kitnic-forks/e100a/README.md

E100A All-Discrete Power Supply Kit
==================================

Work in progress. This will be a semi-educational kit for a bench power
supply made from all discrete components.

3D render
