kitnic-forks/e100a/doc/titlepage/titlepage.tex

\begin{titlepage}

\makeatletter

\centering
\begin{minipage}[c][1in][c]{6in}
\vspace{-1.5in}

\end{minipage}

\vspace{-1in}
\vspace*{\fill}
\begin{center}
{\LARGE\@title}

\vspace{10mm}

\url{http://c4757p.com/projects/ps1}

\end{center}
\vspace*{\fill}

\vspace{-1in}
\begin{minipage}[c][1in][c]{\textwidth}
\begin{center}
 \\
\textcopyright ~\the\year ~\@author.
\end{center}
\end{minipage}

\makeatother

\end{titlepage}
