kitnic-forks/e100a/images/kicad-3d-not-stuffed.png

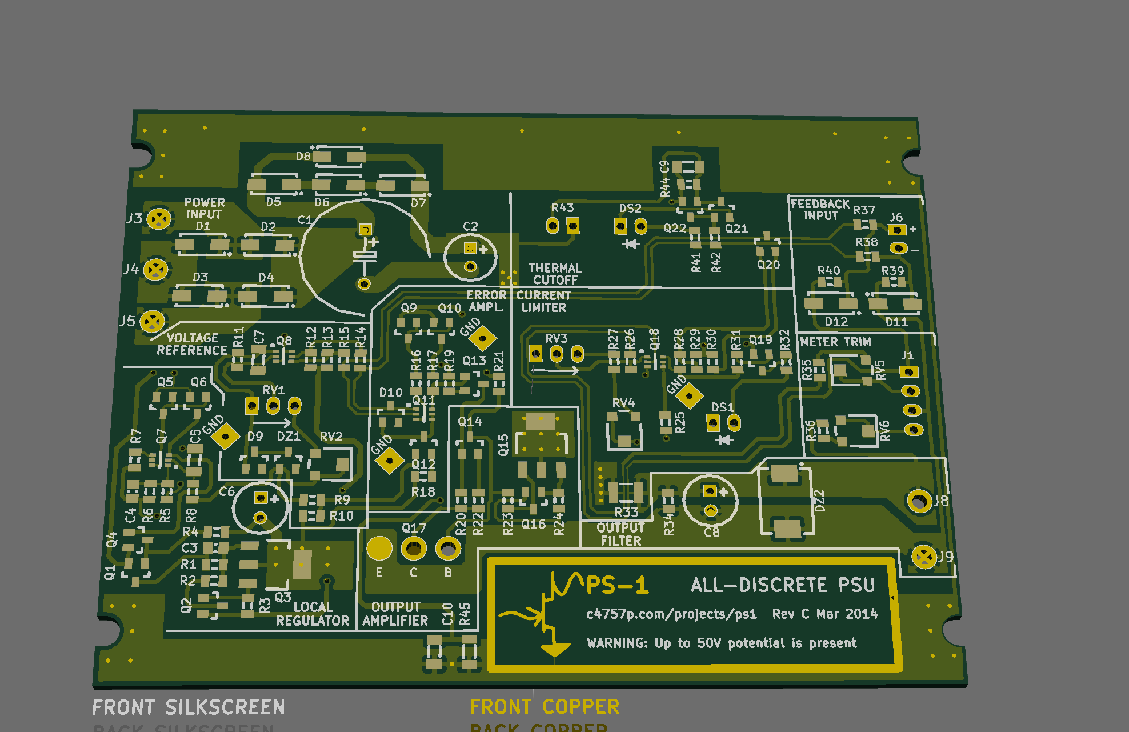
images/kicad-3d-not-stuffed.png
