kitnic-forks/e100a/BOM.ods

Type | Item | Description | Source | Manufacturer | Source PN | Qty | USD Cost qty. | Notes on sourcing
C | C1 | CAP Alum 1000uF 63V [Radial 16mm]
C | C2 | CAP Alum 47uF 63V [Radial 6.3mm]
C | C6 | CAP Alum 47uF 63V [Radial 6.3mm]
C | C8 | CAP Alum 47uF 63V [Radial 6.3mm]
C | C3 | CAP Ceramic 100pF 50V [0805]
C | C4 | CAP Ceramic 1nF 16V [0805]
C | C10 | CAP Ceramic 1nF 1kV [1206]
C | C5 | CAP Ceramic 4.7uF 16V [1206]
C | C7 | CAP Ceramic 4.7uF 16V [1206]
C | C9 | CAP Ceramic 4.7uF 16V [1206]
C | C(FP) | CAP Film 100nF 200V [Radial, long leads]
D | D1 | DIODE 1A 200V [SMA]
D | D11 | DIODE 1A 200V [SMA]
D | D12 | DIODE 1A 200V [SMA]
D | D2 | DIODE 1A 200V [SMA]
D | D3 | DIODE 1A 200V [SMA]
D | D4 | DIODE 1A 200V [SMA]
D | D5 | DIODE 1A 200V [SMA]
D | D6 | DIODE 1A 200V [SMA]
D | D7 | DIODE 1A 200V [SMA]
D | D8 | DIODE 1A 200V [SMA]
D | D10 | DIODE Signal [SOT-23]
D | D9 | DIODE Signal [SOT-23]
D | DZ2 | DIODE TVS 30V WPIV 33A IRSM [SMC-J]
D | DZ1 | DIODE Zener 6.2V 2% [SOT-23]
DS | DS1 | INDICATOR LED Red [Panel 6.35mm] | DigiKey | Bivar | 492-1659-ND |  | $0.404
DS | DS2 | INDICATOR LED Red [Panel 6.35mm] | DigiKey | Bivar | 492-1659-ND |  | $0.404
R | R33 | RES {1 / 0.47 / 1} 5% [1210]
R | R37 | RES {120k 75k 75k} 0.5% [0805]
R | R38 | RES {120k 75k 75k} 0.5% [0805]
R | R35 | RES {180 68 180} 5% [0805]
R | R36 | RES {27k 15k 27k} 5% [0805]
R | R11 | RES 100k 5% [0805]
R | R26 | RES 100k 5% [0805]
R | R42 | RES 100k 5% [0805]
R | R25 | RES 10k 5% [0805]
R | R31 | RES 10k 5% [0805]
R | R32 | RES 10k 5% [0805]
R | R41 | RES 10k 5% [0805]
R | R7 | RES 10k 5% [0805]
R | R8 | RES 10k 5% [0805]
R | R6 | RES 18k 5% [0805]
R | R16 | RES 1k 5% [0805]
R | R17 | RES 1k 5% [0805]
R | R18 | RES 1k 5% [0805]
R | R19 | RES 1k 5% [0805]
R | R20 | RES 1k 5% [0805]
R | R22 | RES 1k 5% [0805]
R | R28 | RES 1k 5% [0805]
R | R29 | RES 1k 5% [0805]
R | R45 | RES 1M 5% [1206]
R | R14 | RES 22k 0.5% [0805]
R | R15 | RES 22k 0.5% [0805]
R | R1 | RES 22k 5% [0805]
R | R12 | RES 22k 5% [0805]
R | R13 | RES 22k 5% [0805]
R | R21 | RES 22k 5% [0805]
R | R23 | RES 22k 5% [0805]
R | R27 | RES 22k 5% [0805]
R | R34 | RES 22k 5% [0805]
R | R4 | RES 22k 5% [0805]
R | R5 | RES 22k 5% [0805]
R | R39 | RES 270 5% [0805]
R | R40 | RES 270 5% [0805]
R | R44 | RES 270 5% [0805]
R | R24 | RES 33 5% [0805]
R | R3 | RES 33 5% [0805]
R | R30 | RES 33 5% [0805]
R | R10 | RES 470 5% [0805]
R | R9 | RES 470 5% [0805]
R | R43 | RES Therm 100k 5% [Radial]
Q | Q15 | TRANS NPN [SOT-223]
Q | Q3 | TRANS NPN [SOT-223]
Q | Q12 | TRANS NPN [SOT-23]
Q | Q14 | TRANS NPN [SOT-23]
Q | Q16 | TRANS NPN [SOT-23]
Q | Q2 | TRANS NPN [SOT-23]
Q | Q22 | TRANS NPN [SOT-23]
Q | Q11 | TRANS NPN Matched [SOT-363]
Q | Q18 | TRANS NPN Matched [SOT-363]
Q | Q7 | TRANS NPN Matched [SOT-363]
Q | Q8 | TRANS NPN Matched [SOT-363]
Q | Q10 | TRANS PNP [SOT-23]
Q | Q19 | TRANS PNP [SOT-23]
Q | Q20 | TRANS PNP [SOT-23]
Q | Q21 | TRANS PNP [SOT-23]
Q | Q5 | TRANS PNP [SOT-23]
Q | Q6 | TRANS PNP [SOT-23]
Q | Q9 | TRANS PNP [SOT-23]
Q | Q1 | TRANS PNP 60V [SOT-23]
Q | Q13 | TRANS PNP 60V [SOT-23]
Q | Q4 | TRANS PNP 60V [SOT-23]
Q | Q17 | TRANS PNP Darlington hFE>=1000 60V w/Diode [TO-220]
J | J(BP) | CONNECTOR IEC-C14 QuickConnect 6.35mm | DigiKey | Qualtek | Q212-ND |  | $0.689
MP | MP-J(BP) | CONNECTOR QuickConnect 6.35mm crimp | DigiKey | Molex | WM5929-ND | 5 | $0.318
SW | SW(FP)2 | SWITCH 250VAC QuickConnect 6.35mm [Panel] | DigiKey | Arcolectric | 1091-1034-ND |  | $1.660
DS | DS3 | INDICATOR LED Red [Panel 6.35mm] | DigiKey | Bivar | 492-1659-ND |  | $0.404
R | R2 | RES 10k 5% [0805]
SW | SW(FP)1 | SWITCH Momentary 3A [Panel] | DigiKey | E-Switch | EG2031-ND |  | $1.970
RV | RV1 | POT 10k Linear [Panel, Solder Lug]
RV | RV2 | POT TRIM 10k [SMD]
RV | RV3 | POT 1k Linear [Panel, Solder Lug]
RV | RV4 | POT TRIM 10k [SMD]
RV | RV5 | POT TRIM 500 [SMD]
RV | RV6 | POT TRIM {20k 10k 10k} [SMD]
M | M(FP) | METER 1mA, 240 ohm, custom scale [Panel] | AliExpress |  | 1180028889 |  | $3.210
L | L(FP) | FERRITE Ring 161 ohm @ 1 turn [10mm inner] | DigiKey | Wurth | 732-1522-ND |  | $0.739
MP | MP-F(FP) | SOCKET Fuse 6.3mm [Inline] | DigiKey | Littelfuse | F3108-ND |  | $0.740
F | F(FP) | FUSE 1A 125V slow [6.3mm] | DigiKey | Bel Fuse | 507-1526-ND |  | $0.334
