kitnic-forks/e100a/simulation/sim-full.asc

C1: polcap; 1000µ; V=63
C2: polcap; 47µ; V=63 Rser=2.6
C3: cap; 330p
C4: cap; 1n
C5: cap; 4µ7
C6: polcap; 47µ; V=63 Rser=2.6
C7: cap; 4µ7
C8: polcap; 47µ; V=63 Rser=2.6
C9: cap; 1n
C10: cap; 1n
D1: diode; S1D
D2: diode; S1D
D3: diode; S1D
D4: diode; S1D
D5: diode; S1D
D6: diode; S1D
D7: diode; S1D
D8: diode; S1D
D9: diode; 1N4148
D10: diode; 1N4148
D11: diode; 1N4148
DZ1: diode; BZX84C6V2
Q1: pnp; 3906
Q2: npn; 3904
Q3: npn; 2N2222
Q4: pnp; 3906
Q5: pnp; 3906
Q6: pnp; 3906
Q7: pnp; 3906
Q7A: npn; 3904
Q7B: npn; 3904
Q8: npn; 3904
Q8A: npn; 3904
Q8B: npn; 3904
Q9: pnp; 3906
Q10: pnp; 3906
Q11: npn; 3904
Q11A: npn; 3904
Q11B: npn; 3904
Q12: npn; 3904
Q13: npn; 3904
Q14: npn; 3904
Q15: npn; 2N2222
Q16: npn; 3904
Q17: npn; 3904
Q18: pnp; 3906
R1: res; 22k
R2: res; 33
R3: res; 33
R4: res; 22k
R5: res; 30k
R6: res; 22k
R7: res; 10k
R8: res; 10k
R9: res; 470
R10: res; 470
R11: res; 100k
R12: res; 22k
R13: res; 22k
R14: res; 22k
R15: res; 22k
R16: res; 1k
R17: res; 1k
R18: res; 22k
R19: res; 1k
R20: res; 1k
R21: res; 22k
R22: res; 1k
R23: res; 22k
R24: res; 33
R25: res; 33
R26: res; 1k
R27: res; {IPOT}
R28: res; {1k-IPOT}
R29: res; {22k+ITRIM}
R30: res; 100k
R31: res; 10k
R32: res; 2k
R33: res; 1
R34: res; 22k
R35: res; 2k
R36: res; 1k
R37: res; 120k
R38: res; 120k
R39: res; 10k
R40: res; R=12/(0.1*time+1u)
R41: res; 1k
RV1A: res; {VPOT}
RV1B: res; {10k-VPOT}
RV2: res; {VTRIM}
U1: pnp-subckt; TIP105
V1: voltage; SINE(0 40 60)
V2: voltage; 0
V3: voltage; 0
V4: voltage; 0; AC 1
V5: voltage; 2; Rser=.1
V6: voltage; 38; Rser=.1
V7: voltage; 12; Rser=.1
Named nets: V-UNREG, 0, +2, -12, SENSE+, SENSE-, nfb, nfbin
.model S1D D
.lib diode.lib
.tran 10 startup
.model 3906 ako:2N3906
.model 3904 ako:2N3904
.param VTRIM 5k
.param VPOT 5k
.lib TIP105.lib
.param ITRIM 5k
.param IPOT 500
;ac dec 100 10 100Meg
