kitnic-forks/e100a/Proj-Main/psu.kicad_pcb

## KiCad design Proj-Main/psu.kicad_pcb (2014-05-16)

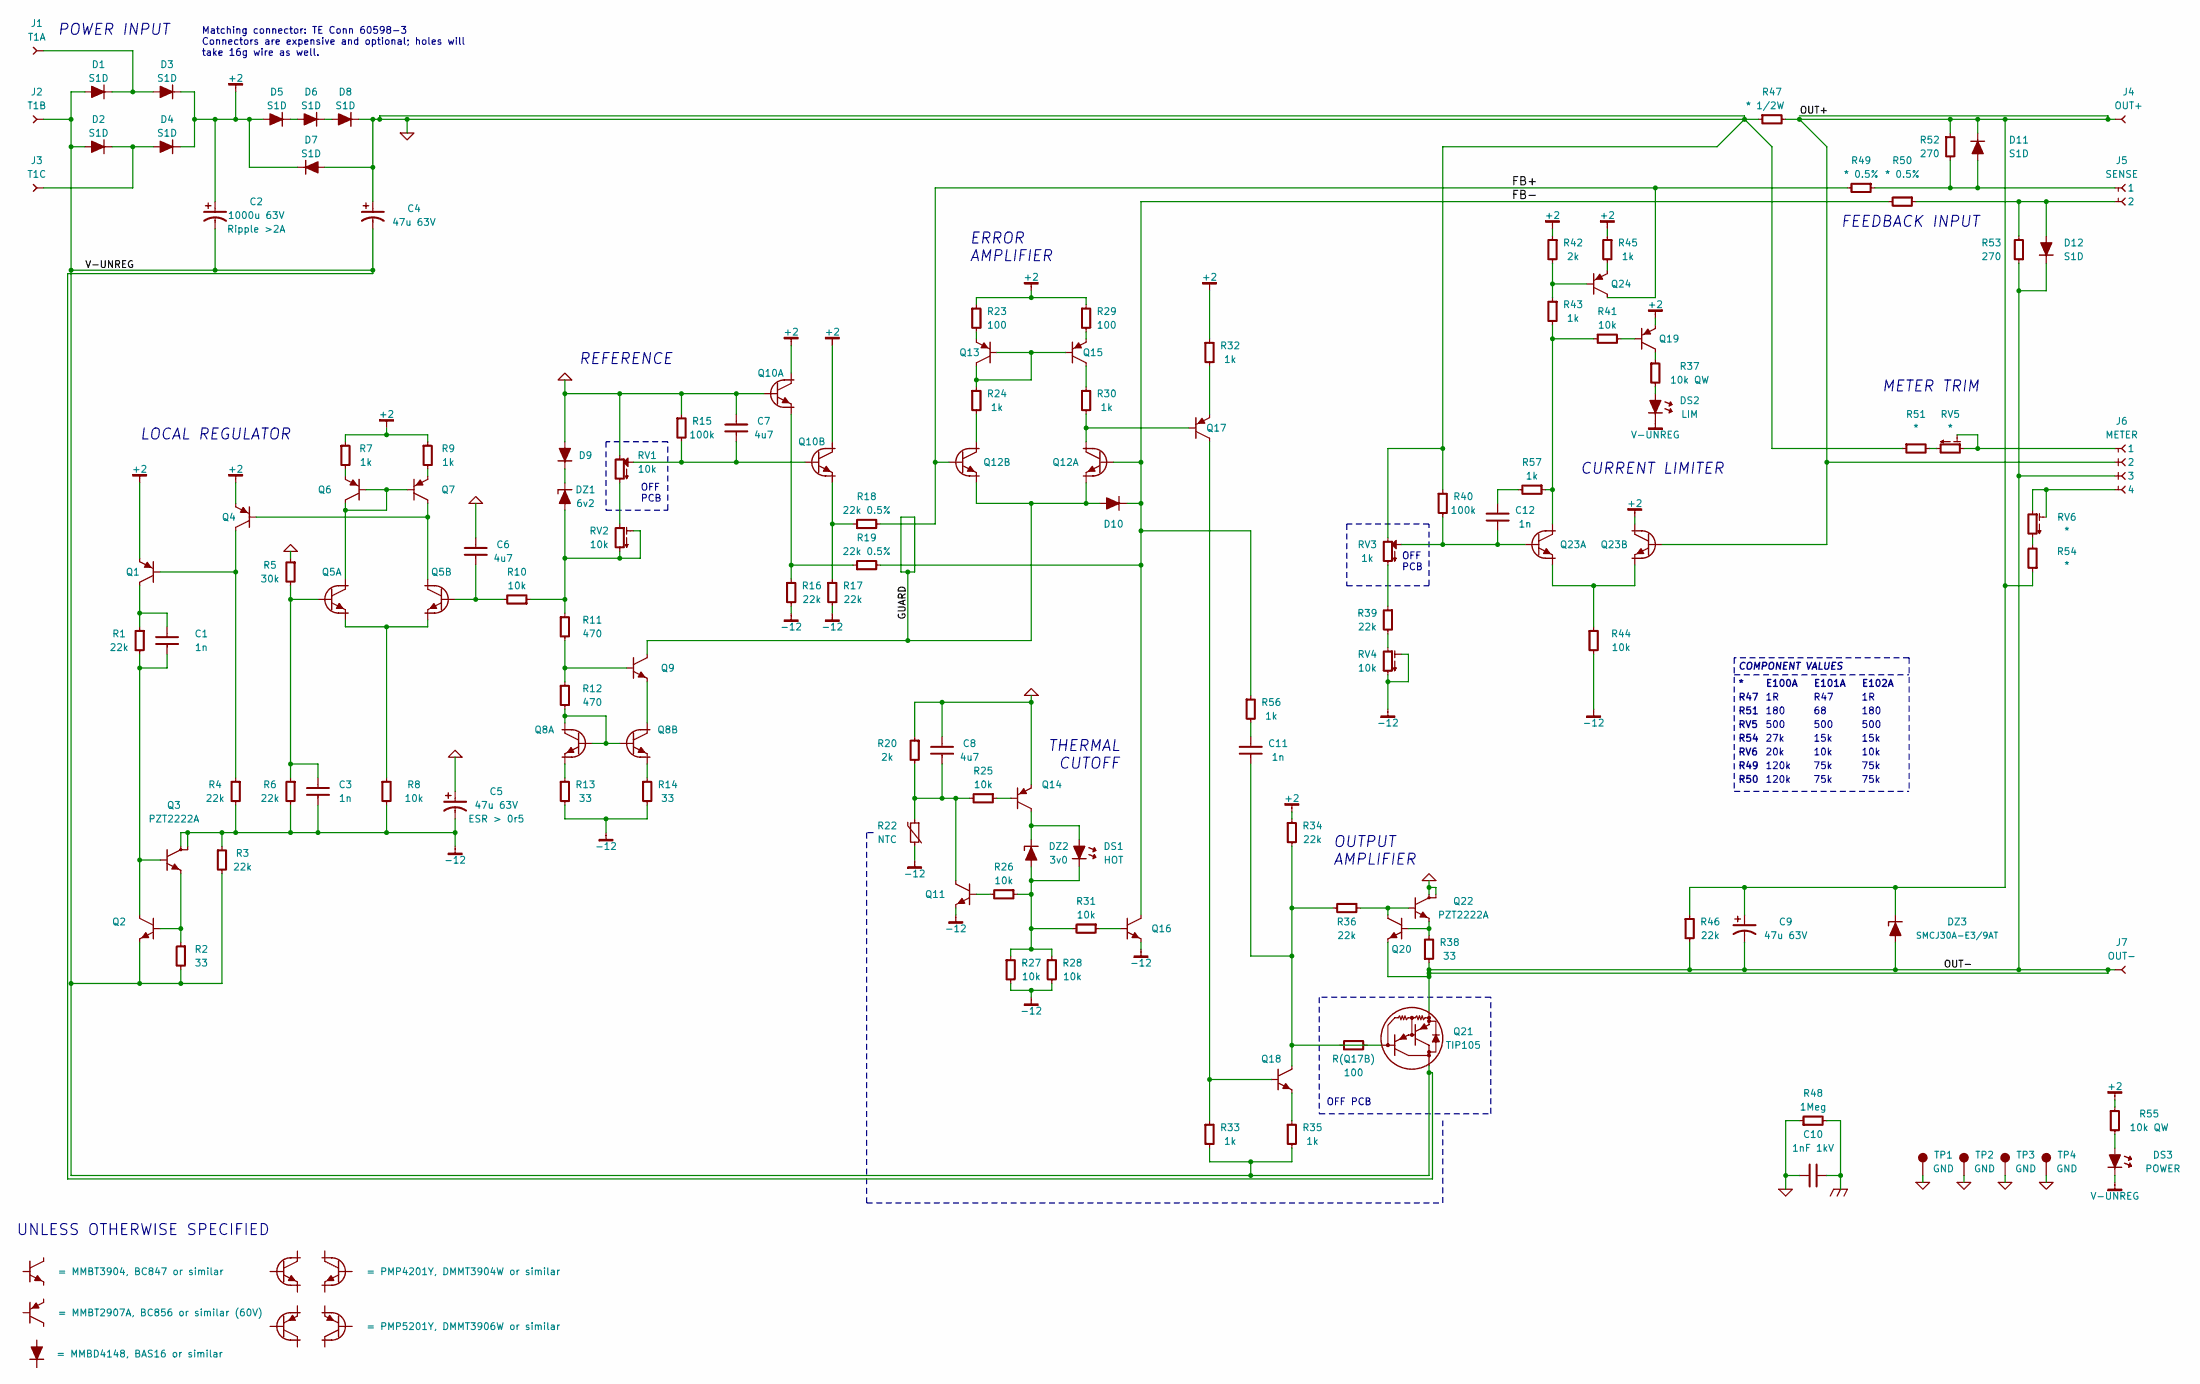
[picture p2: schematic psu.sch, E100A ALL-DISCRETE POWER SUPPLY]

Parts:
C1, C3, C11, C12: 1n
C2: 1000u 63V
C4, C5, C9: 47u 63V
C6, C7, C8: 4u7
C10: 1nF 1kV
D1, D2, D3, D4, D5, D6, D7, D8, D11, D12: S1D
D9, D10: MMBD4148
DS1: HOT; PartNo PM5RD
DS2: LIM; PartNo PM5RD
DS3: POWER; PartNo PM5RD
DZ1: 6v2; PartNo BZX84-B6V2
DZ2: 3v0
DZ3: SMCJ30A-E3/9AT
J1: T1A; PartNo 60824-1
J2: T1B; PartNo 60824-1
J3: T1C; PartNo 60824-1
J4: OUT+; PartNo 60824-1
J5: SENSE
J6: METER
J7: OUT-; PartNo 60824-1
Q1, Q4, Q13, Q15, Q17: BC856
Q2, Q9, Q11, Q16, Q18, Q20: MMBT3904
Q3, Q22: PZT2222A
Q5, Q8, Q10, Q12, Q23: PMP4201Y
Q6, Q7: MMBT3906
Q14, Q19, Q24: MMBT2907A
Q21: TIP105
R1, R3, R4, R6, R16, R17, R34, R36, R39, R46: 22k
R2, R13, R14, R38: 33
R5: 30k
R7, R9, R24, R30, R32, R33, R35, R43, R45, R56, R57: 1k
R8, R10, R25, R26, R27, R28, R31, R41, R44: 10k
R11, R12: 470
R15, R40: 100k
R18, R19: 22k 0.5%
R20, R42: 2k
R22: NTC; PartNo NTCLE100E3334JB0; MouserPN 594-2381-640-63104
R23, R29: 100
R37, R55: 10k QW
R47: * 1/2W
R48: 1Meg
R49, R50: * 0.5%
R51, R54: *
R52, R53: 270
RV1, RV2, RV4: 10k
RV3: 1k
RV5, RV6: *
TP1, TP2, TP3, TP4: GND

Connections:
+2: C2.1, D3.1, D4.1, D5.2, D7.1, Q1.2, Q4.2, Q10.3, Q10.6, Q19.2, Q23.3, R7.1, R9.1, R23.1, R29.1, R32.1, R34.1, R42.1, R45.1, R55.1
-12: C3.2, C5.2, Q3.2, Q3.4, Q11.2, Q16.2, R3.1, R4.2, R6.2, R8.2, R13.2, R14.2, R16.2, R17.2, R22.2, R27.2, R28.2, R44.2, RV4.2, RV4.3
/FB+: Q12.2, Q24.3, R18.2, R49.2
/FB-: D10.3, Q12.1, Q16.3, R19.2, R50.2, R56.1
/GUARD: D10.1, Q9.3, Q12.4, Q12.5
/OUT+: C9.1, D11.1, DZ3.K, J4.1, J6.2, Q23.2, R46.1, R47.2, R52.1, R54.1
/OUT-: C9.2, D12.1, DZ3.A, J6.3, J7.1, Q20.2, Q21.3, R38.1, R46.2, R53.1
CGND: C10.2, R48.2
GND: C4.1, C5.1, C6.1, C7.1, C8.1, C10.1, D7.2, D8.1, D9.1, Q10.1, Q14.2, Q22.2, Q22.4, R5.1, R15.1, R20.1, R40.1, R47.1, R48.1, R51.1, RV1.1, RV3.1, TP1.1, TP2.1, TP3.1, TP4.1
unnamed: C1.1, Q1.3, R1.1
unnamed: C1.2, Q2.3, Q3.1, R1.2
unnamed: C3.1, Q5.1, R5.2, R6.1
unnamed: C6.2, Q5.2, R10.2
unnamed: C7.2, Q10.2, R15.2, RV1.2
unnamed: C8.2, Q11.3, R20.2, R22.1, R25.2
unnamed: C11.1, R56.2
unnamed: C11.2, Q18.3, Q21.1, R34.2, R36.2
unnamed: C12.1, R57.2
unnamed: C12.2, Q23.1, R40.2, RV3.2
unnamed: D1.1, D3.2, J1.1
unnamed: D2.1, D4.2, J3.1
unnamed: D5.1, D6.2
unnamed: D6.1, D8.2
unnamed: D9.3, DZ1.3
unnamed: D11.2, J5.1, R49.1, R52.2
unnamed: D12.2, J5.2, R50.1, R53.2
unnamed: DS1.A, DZ2.3, Q14.3
unnamed: DS1.K, DZ2.1, R26.1, R27.1, R28.1, R31.2
unnamed: DS2.A, R37.2
unnamed: DS3.A, R55.2
unnamed: DZ1.1, R10.1, R11.1, RV2.2, RV2.3
unnamed: J6.1, RV5.1, RV5.2
unnamed: J6.4, RV6.1, RV6.2
unnamed: Q1.1, Q4.3, R4.1
unnamed: Q2.1, Q3.3, R2.1
unnamed: Q4.1, Q5.3, Q7.3
unnamed: Q5.4, Q5.5, R8.1
unnamed: Q5.6, Q6.1, Q6.3, Q7.1
unnamed: Q6.2, R7.2
unnamed: Q7.2, R9.2
unnamed: Q8.1, Q8.2, Q8.6, R12.2
unnamed: Q8.3, Q9.2
unnamed: Q8.4, R14.1
unnamed: Q8.5, R13.1
unnamed: Q9.1, R11.2, R12.1
unnamed: Q10.4, R17.1, R18.1
unnamed: Q10.5, R16.1, R19.1
unnamed: Q11.1, R26.2
unnamed: Q12.3, R24.2
unnamed: Q12.6, Q17.1, R30.2
unnamed: Q13.1, Q13.3, Q15.1, R24.1
unnamed: Q13.2, R23.2
unnamed: Q14.1, R25.1
unnamed: Q15.2, R29.2
unnamed: Q15.3, R30.1
unnamed: Q16.1, R31.1
unnamed: Q17.2, R32.2
unnamed: Q17.3, Q18.1, R33.1
unnamed: Q18.2, R35.1
unnamed: Q19.1, R41.2
unnamed: Q19.3, R37.1
unnamed: Q20.1, Q22.3, R38.2
unnamed: Q20.3, Q22.1, R36.1
unnamed: Q23.4, Q23.5, R44.1
unnamed: Q23.6, R41.1, R43.2, R57.1
unnamed: Q24.1, R42.2, R43.1
unnamed: Q24.2, R45.2
unnamed: R39.1, RV3.3
unnamed: R39.2, RV4.1
unnamed: R51.2, RV5.3
unnamed: R54.2, RV6.3
unnamed: RV1.3, RV2.1
V-UNREG: C2.2, C4.2, D1.2, D2.2, DS2.K, DS3.K, J2.1, Q2.2, Q21.2, R2.2, R3.2, R33.2, R35.2

Notes on the sheet:
ERROR AMPLIFIER
POWER INPUT
UNLESS OTHERWISE SPECIFIED
THERMAL CUTOFF
COMPONENT VALUES
E100A
E101A
E102A
R51
180
R54
27k
15k
RV5
500
RV6
20k
10k
R47
LOCAL REGULATOR
REFERENCE
OUTPUT AMPLIFIER
CURRENT LIMITER
FEEDBACK INPUT
METER TRIM
Matching connector: TE Conn 60598-3 Connectors are expensive and optional; holes will take 16g wire as well.
R49
120k
75k
R50
OFF PCB
OFF PCB

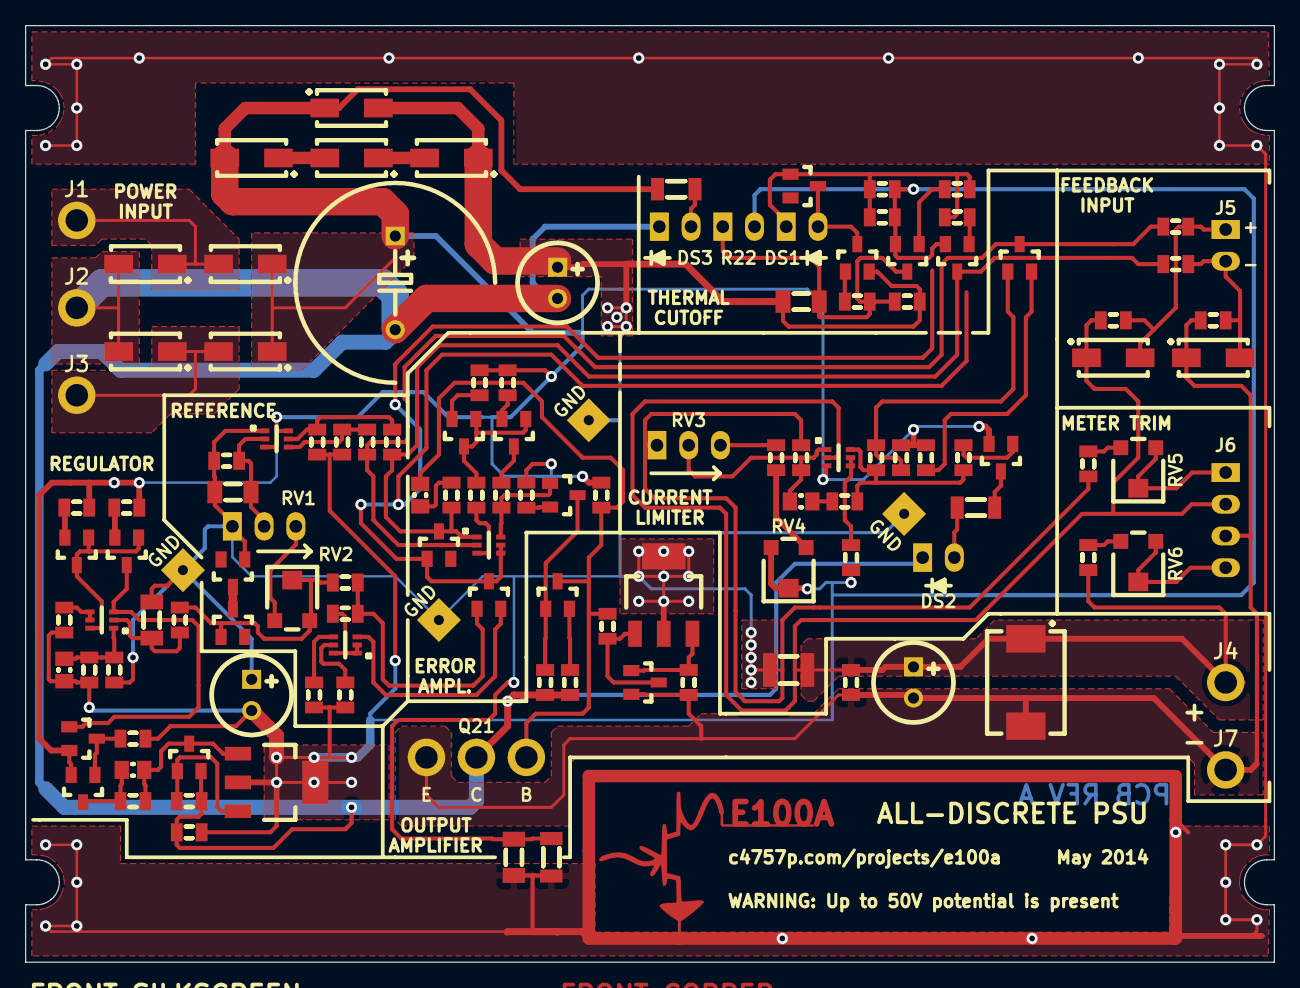
[picture p3: board psu.kicad_pcb from above]

Board: 2 copper layers, 100.0 x 75.0 mm, 127 parts (0 on the bottom side), 73 nets.
