kitnic-forks/e100a/(commit log)

2014-01-24 Finally put this in a git repo...
    [BOM.ods, log-fixed.csv, log.csv, logC.csv, noiseamp.kicad_pcb, noiseamp.sch, partsboard.ods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]
2014-01-24 Changed local regulator circuit, added github readme
    [Reference.sch, psu.kicad_pcb, psu.sch]
2014-03-18 Rev C in progress
    [BOM.ods, psu.kicad_pcb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]
2014-03-18 Added PCB render?
    Will this work?
    [psu.GBL, psu.GBO, psu.GBS, psu.GTL, psu.GTO, psu.GTS]
2014-03-18 Added beginning of simulation
    [psu.sch]
2014-03-23 Few BOM-related changes
    [BOM.ods, psu.kicad_pcb, psu.sch]
2014-03-23 Moved noise amplifier out of project
    [log-fixed.csv, log.csv, logC.csv, noiseamp.kicad_pcb, noiseamp.sch]
2014-03-23 Removed revision A PCB
    [psu.kicad_pcb]
2014-03-23 Moved main KiCad project into Proj-Main/
    [Reference.sch, partsboard.ods, psu.kicad_pcb, psu.sch]
2014-03-23 Created separate wiring diagram
    [psu-wiring.sch, psu.sch]
2014-05-04 Added R46, R47
    [psu.kicad_pcb, psu.sch]
2014-05-04 Added power LED DS3
    [psu.kicad_pcb]
2014-05-04 Added regulator bootstrap resistor R48
    [psu.kicad_pcb, psu.sch]
2014-05-04 Adjusted regulator feedback resistors
    [psu.sch]
2014-05-04 Improved design of current source
    [psu.kicad_pcb, psu.sch]
2014-05-04 Added new thermal cutoff
    [psu.kicad_pcb, psu.sch]
2014-05-04 Added current mirror degeneration resistors R54, R55
    [psu.kicad_pcb, psu.sch]
2014-05-04 Renamed voltage rails (V+ and V- now +2 and -12)
    [psu.kicad_pcb, psu.sch]
2014-05-04 Updated LED bias points
    [psu.kicad_pcb, psu.sch]
2014-05-04 Rearranged schematic
    [psu.kicad_pcb, psu.sch]
2014-05-04 Reannotated schematic
    [psu.kicad_pcb, psu.sch]
2014-05-04 PCB tweaks
    [psu.kicad_pcb]
2014-05-05 More PCB tweaks
    [psu.kicad_pcb]
2014-05-05 PCB and rendering tweaks
    [psu.kicad_pcb, psu.sch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]
2014-05-05 Zone under Q3 was assigned to the wrong net
    [psu.kicad_pcb]
2014-05-05 Frequency compensation
    [psu.kicad_pcb, psu.sch]
2014-05-05 Fixed another disconnected zone
    [psu.kicad_pcb]
2014-05-05 Straightened crooked trace
    [psu.kicad_pcb]
2014-05-07 Added guard traces, fixed overlapping components
    [psu.kicad_pcb, psu.sch]
2014-05-07 Corrected missing connection
    [psu.kicad_pcb]
2014-05-14 Removed thermals from high-current pads
    [psu.kicad_pcb]
2014-05-15 Some PCB tweaks
    [psu.kicad_pcb, psu.sch]
2014-05-16 PCB REV A
    [psu.kicad_pcb, psu.sch]
